bdk6/lcbdk/README.md

# lcbdk
L C meter based on Almost All Digital Electronics LC Meter written up in Nuts n Volts (Neil Hecht)
