bdk6/lcbdk/docs/lcm-schematic.gif

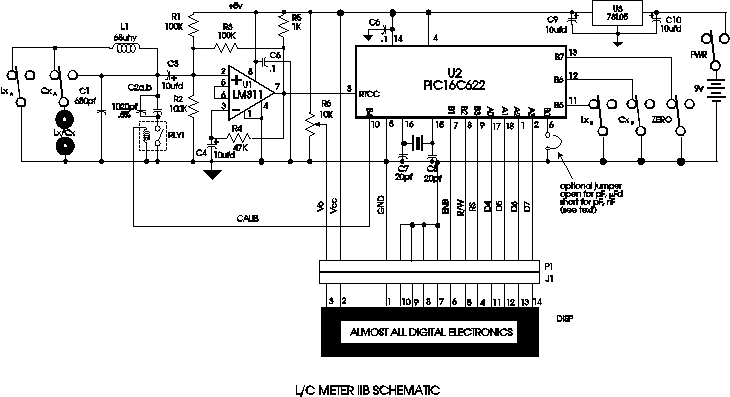
docs/lcm-schematic.gif
