bdk6/lcbdk/electronics/lcbdk/lcbdk.kicad_pcb

## KiCad design electronics/lcbdk/lcbdk.kicad_pcb (2023-04-04)

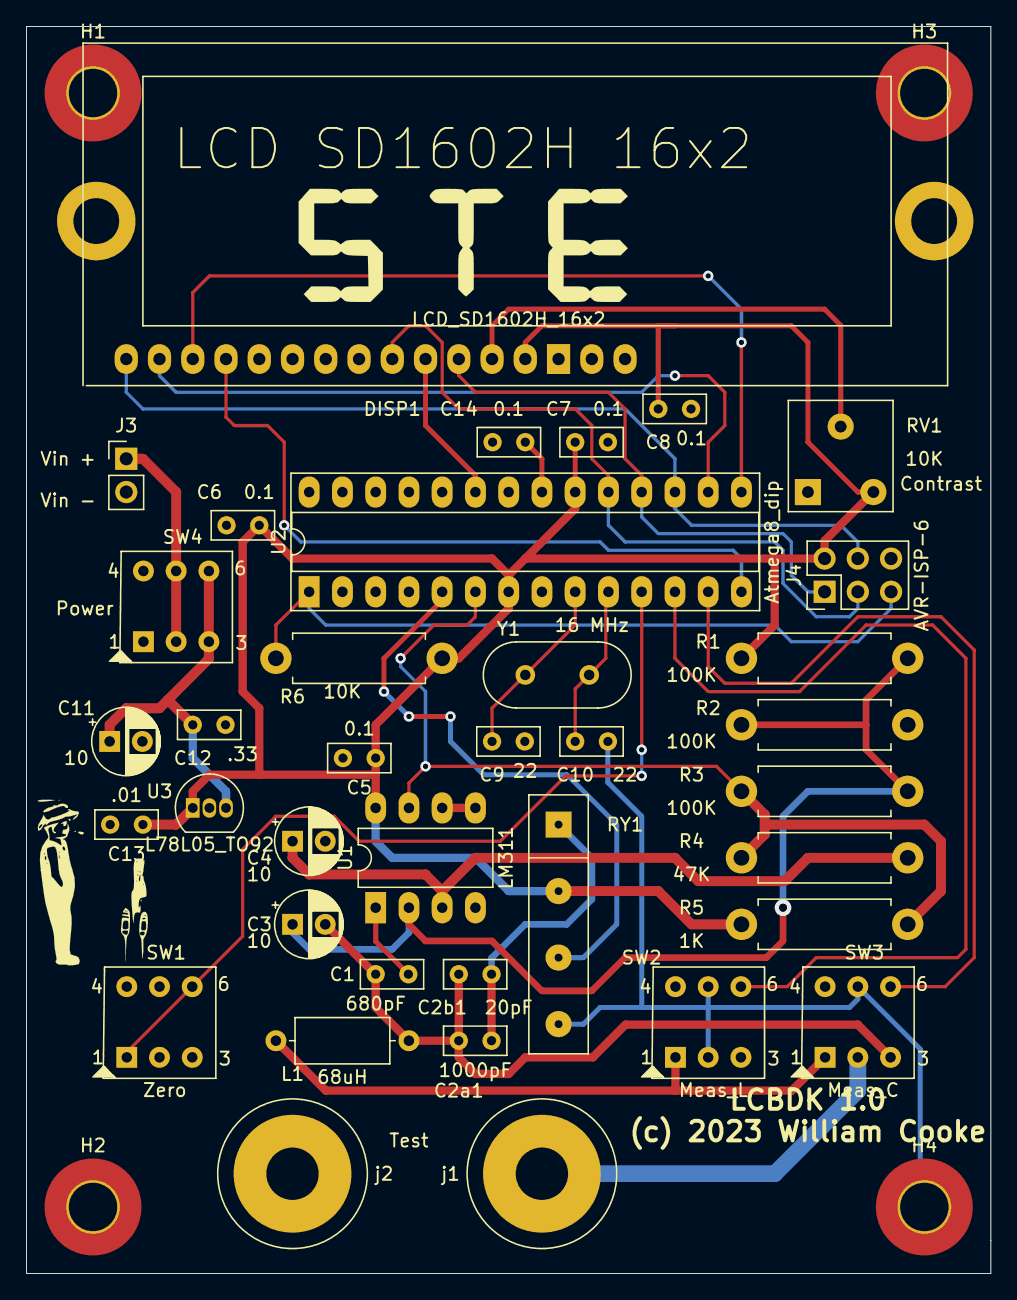
[picture p4: board lcbdk.kicad_pcb from above]

Board: 2 copper layers, 73.7 x 95.2 mm, 41 parts (0 on the bottom side), 28 nets.

Parts:
C1: 680pF; C_Rect_L4.6mm_W2.0mm_P2.50mm_MKS02_FKP02
C2a1: 1000pF; C_Rect_L4.6mm_W2.0mm_P2.50mm_MKS02_FKP02
C2b1: 20pF; C_Rect_L4.6mm_W2.0mm_P2.50mm_MKS02_FKP02
C3, C4, C11: 10; CP_Radial_D5.0mm_P2.50mm
C5, C6, C7, C8, C14: 0.1; C_Rect_L4.6mm_W2.0mm_P2.50mm_MKS02_FKP02
C9, C10: 22; C_Rect_L4.6mm_W2.0mm_P2.50mm_MKS02_FKP02
C12: .33; C_Rect_L4.6mm_W2.0mm_P2.50mm_MKS02_FKP02
C13: .01; C_Rect_L4.6mm_W2.0mm_P2.50mm_MKS02_FKP02
DISP1: LCD_SD1602H_16x2; LCD_SD1602H
H1, H2, H3, H4: M3; MountingHole_3.7mm_Pad_TopBottom
J3: Conn_01x02; PinHeader_1x02_P2.54mm_Vertical
J4: AVR-ISP-6; PinHeader_2x03_P2.54mm_Vertical
L1: 68uH; L_Axial_L7.0mm_D3.3mm_P10.16mm_Horizontal_Fastron_MICC
R1, R2, R3: 100K; R_Axial_DIN0411_L9.9mm_D3.6mm_P12.70mm_Horizontal
R4: 47K; R_Axial_DIN0411_L9.9mm_D3.6mm_P12.70mm_Horizontal
R5: 1K; R_Axial_DIN0411_L9.9mm_D3.6mm_P12.70mm_Horizontal
R6: 10K; R_Axial_DIN0411_L9.9mm_D3.6mm_P12.70mm_Horizontal
RV1: 10K; Tayda_Tokyo_Denshi_RM065_trimmer
RY1: COMUS_ReedRelay_3570-1331; COMUS_Relay_35701331
SW1: Zero; ESwitch_TL2202_DPDT
SW2: Meas_L; ESwitch_TL2202_DPDT
SW3: Meas_C; ESwitch_TL2202_DPDT
SW4: TE2202; ESwitch_TL2202_DPDT
U1: LM311; DIP-8_W7.62mm_LongPads
U2: Atmega8_dip; DIP-28_W7.62mm_Socket_LongPads
U3: L78L05_TO92; TO-92_Inline
Y1: 16 MHz; Crystal_HC49-U_Vertical
j1, j2: Binding Post; tayda_binding_post

Connections:
GND: C1.2, C4.2, C5.2, C6.2, C7.2, C8.2, C9.2, C10.2, C11.2, C12.2, C13.2, C14.2, DISP1.1, H1.1, H2.1, H3.1, H4.1, J3.2, J4.6, R2.2, RV1.1, RY1.4, SW1.2, SW1.5, SW2.2, SW2.5, SW3.5, U1.1, U1.4, U2.8, U2.22, U3.2, j2.1
unnamed: C1.1, C2a1.1, C2b1.1, C3.2, L1.2, SW3.3
unnamed: C2a1.2, C2b1.2, RY1.1
unnamed: C3.1, R1.2, R2.1, R3.2, U1.2
unnamed: C4.1, R4.2, U1.3
unnamed: C9.1, U2.9, Y1.1
unnamed: C10.1, U2.10, Y1.2
unnamed: C11.1, C12.1, SW4.3, SW4.6, U3.3
unnamed: C14.1, U2.21
unnamed: DISP1.3, RV1.2
unnamed: DISP1.4, J4.1, U2.18
unnamed: DISP1.5, U2.23
unnamed: DISP1.6, J4.3, U2.19
unnamed: DISP1.11, U2.14
unnamed: DISP1.12, U2.15
unnamed: DISP1.13, U2.16
unnamed: DISP1.14, J4.4, U2.17
unnamed: J3.1, SW4.2, SW4.5
unnamed: J4.5, R6.2, U2.1
unnamed: L1.1, SW2.1, SW3.1
unnamed: R3.1, R4.1, R5.2, U1.7, U2.6
unnamed: RY1.3, U2.5
unnamed: SW1.1, SW1.6, U2.11
unnamed: SW2.6, U2.12
unnamed: SW3.2, j1.1
unnamed: SW3.6, U2.13
unnamed: U1.5, U1.6
VCC: C5.1, C6.1, C7.1, C8.1, C13.1, DISP1.2, J4.2, R1.1, R5.1, R6.1, RV1.3, RY1.2, U1.8, U2.7, U2.20, U3.1
