bdk6/lcbdk/(commit log)

2021-07-13 Copied original Arduino code into repo.
2021-07-13 (re)created initial schematic
    [lcbdk.kicad_pcb, lcbdk.sch]
2023-03-07 Modified schematic and added basic working code.
2023-03-10 Enhanced code, added more to schematic.
    [lcbdk.sch]
2023-03-20 Updated schematic. More code. Added docs.
    [lcbdk.sch]
2023-04-02 Finished first iteration PCB.
    [lcbdk.sch]
2023-04-04 Final PCB design.
    [lcbdk-B_Cu.gbl, lcbdk-B_Mask.gbs, lcbdk-B_Paste.gbp, lcbdk-B_SilkS.gbo, lcbdk-Edge_Cuts.gm1, lcbdk-F_Cu.gtl, lcbdk-F_Mask.gts, lcbdk-F_Paste.gtp]
