bdk6/lcbdk/(notices)

Notices in the files:
electronics/lcbdk/lcbdk.kicad_pcb:
(c) 2023 William R Cooke / Small Time Electronics
